bencer3283/IoT-Lab/HW1/HW1-BOM.xlsx

Comment | Designator | Footprint | Quantity | Value | Manufacturer Part Number | Manufacturer_Part_Number | Mouser Part Number
Cap Semi | 3.3v-10uf | C1206 | 1 | 10uF |  |  | 80-C1206C106K4P
Cap Semi | 3.3v-47uf | C1206 | 1 | 47uF |  | C3216X7S0J476M160AC
AMS1117-3.3 | 3.3v supply | SOT229P700X180-4N | 1 |  |  | AMS1117-3.3
PJ-047A | 5V jack | FP-PJ-047A-MFG | 1 |  | PJ-047A | PJ-047A
Inductor | analogdecouple, analogdecouple2 | INDC1608L | 2 | 10uH |  | KLZ1608MHR100WTD25
Cap Semi | crystal1, crystal2 | C1206 | 2 | 22uF |  | CC1206KKX5R6BB226
TSX-3225 16.0000MF18X-AC3 | Crystal | EPSON-TSX-3225_V | 1 |  |  |  | 732-TX325-16F09Z-AC3
Res3 | current-limit5v, current-limit33 | J1-0603 | 2 | 330 |  |  | 667-ERJ-3EKF3300V
 | decouple, decouple1, decouple2, decouple4 | C1206 | 4 | 100nF |  |  | 80-C1206C104K5RACLR
Res3 | dht-pull-up, photodiodeR, reset | J1-0603 | 3 | 10K |  |  | 603-RC0603FR-0710KL
Res3 | ds18pull-up | J1-0603 | 1 | 4.7K |  |  | 71-CRCW06034K70JNEAC
ATmega328P-AU | MCU1 | 32A_N | 1 |  |  | ATMEGA328P-AU
BPW21R | Photodiode | VISH-BPW21R-2 | 1 |  |  | BPW21R
LED2 | power, power33 | 3.2X1.6X1.1 | 2 |  |  | APTR3216SECK
Header 3X2 | Programming | HDR2X3 | 1 |  |  | 206832-0601
PTS636_SK43_SMTR_LFS | resetSwitch | PTS636SK43SMTRLFS | 1 |  |  | PTS636 SK43 SMTR LFS | 611-PTS636SK43SMTRLF
DHT22 | Thermal&Humiditysensor1 | DHT22 | 1 |  |  | DHT22
DS18B20+ | Thermalsnesor1 | Q3+1 | 1 |  |  | DS18B20+
XB24CZ7PIT-004 | XBee | XB24CAPIT-001 | 1 |  |  | XB24CZ7PIT-004 | 888-XB24CZ7PIT-004
