bencer3283/IoT-Lab/HW1/HW1.pdf

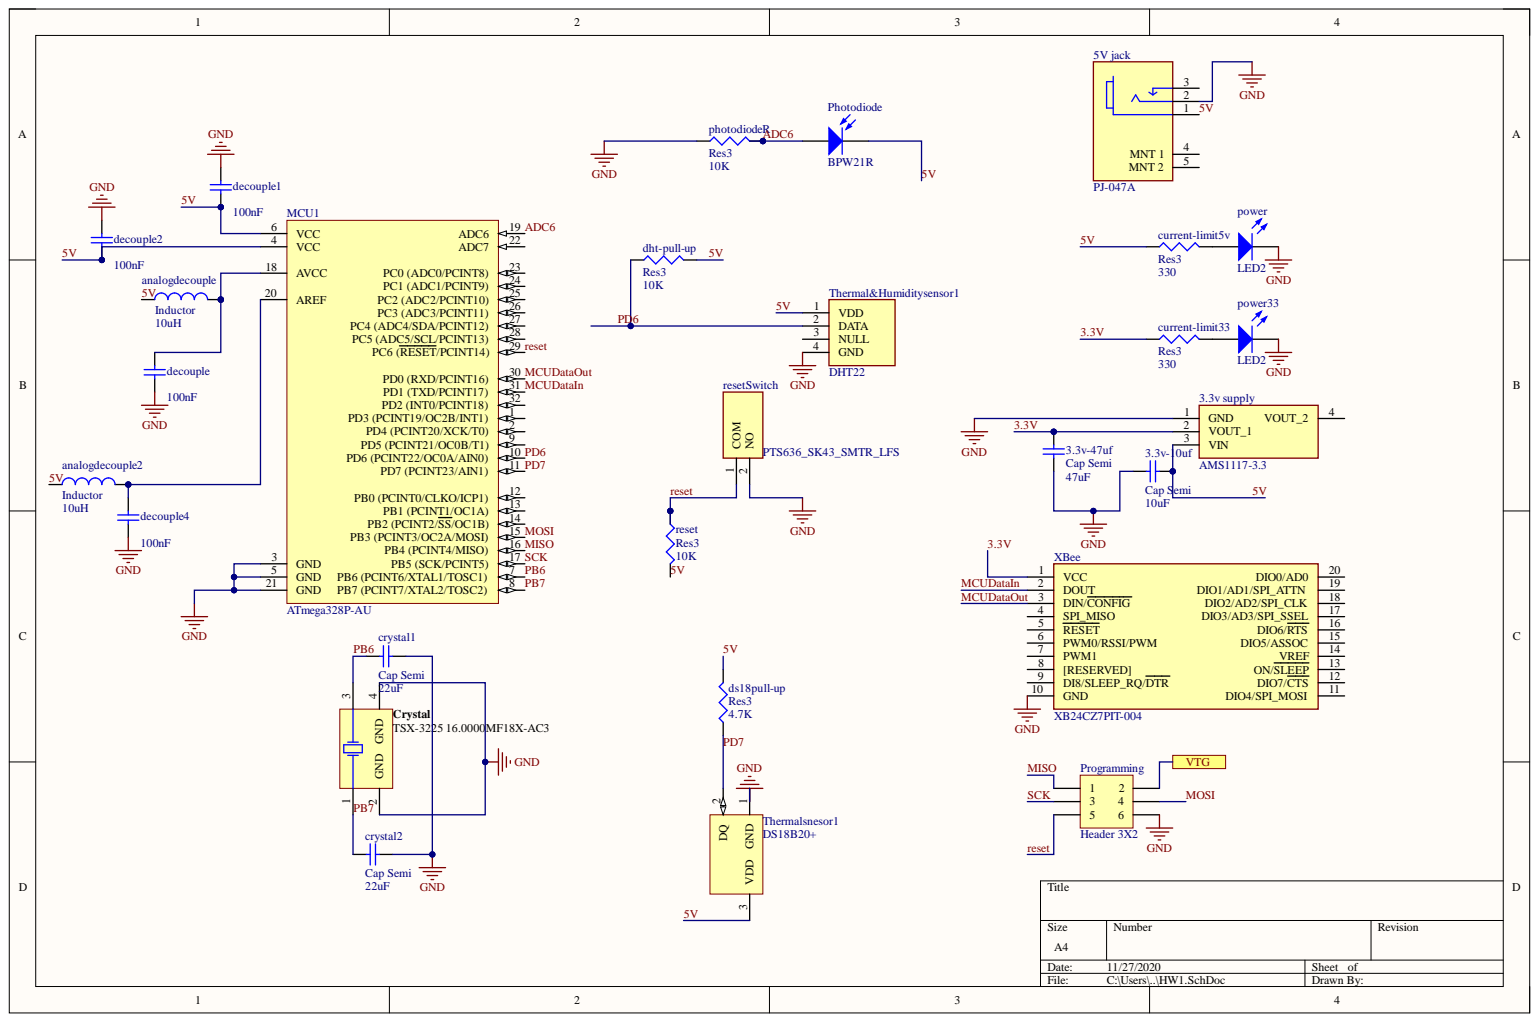
[picture p17: page 1]

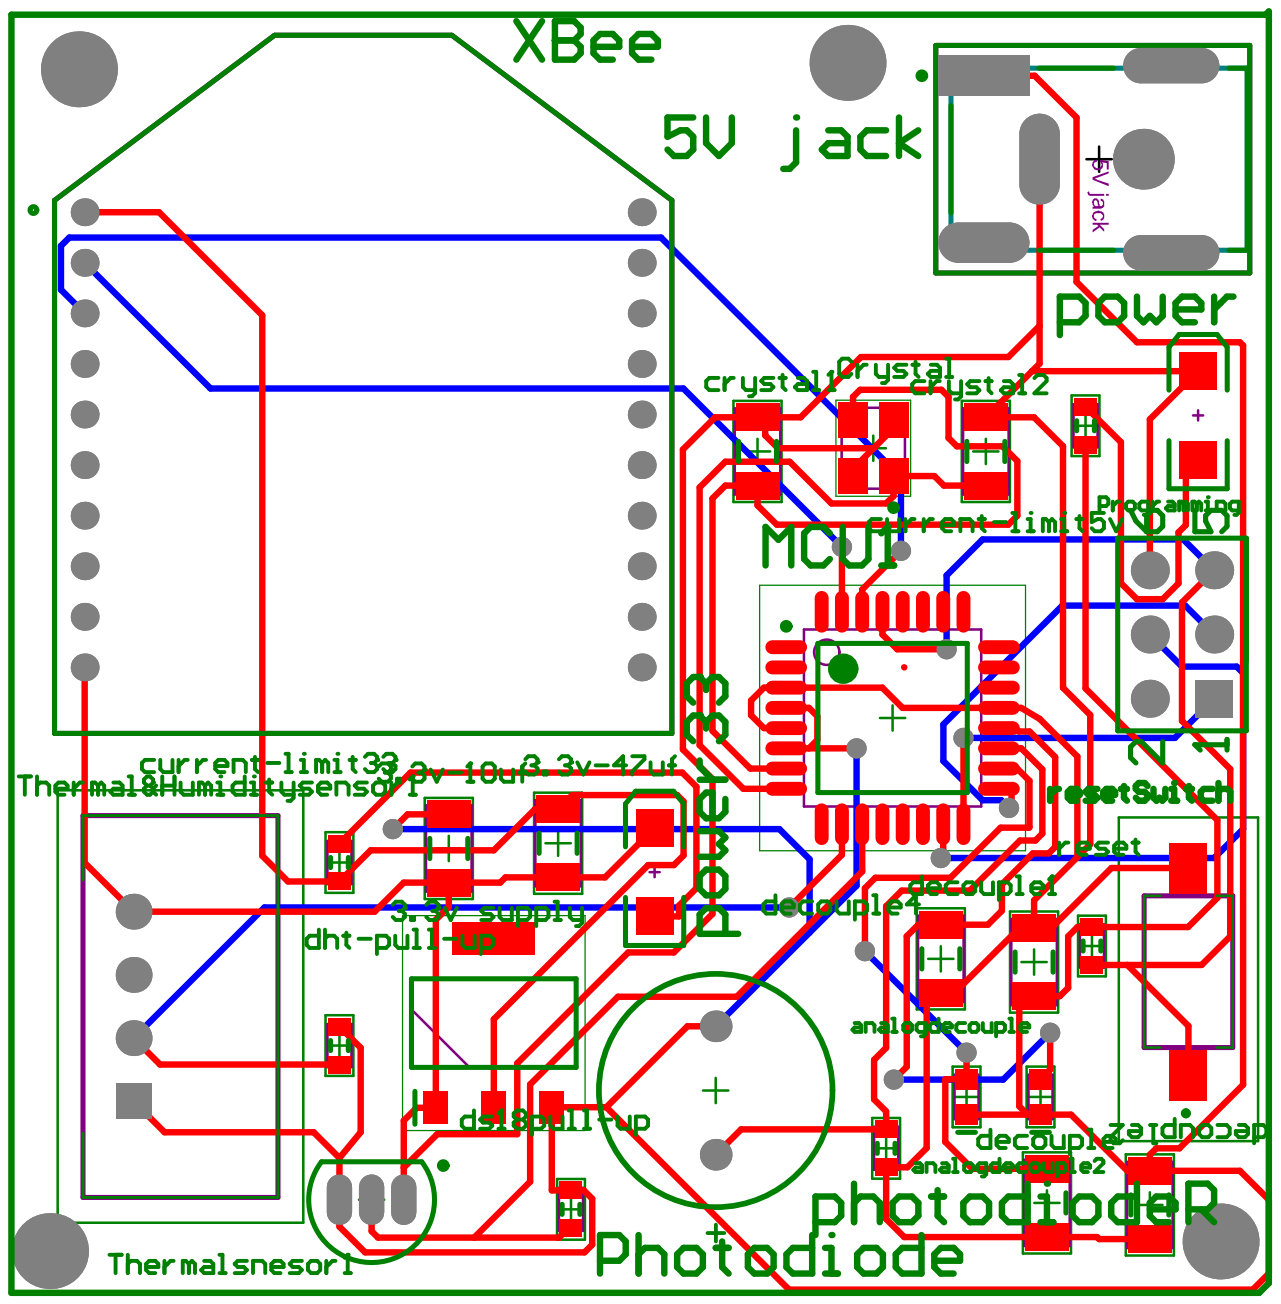
[picture p18: page 2]

Part List | Bill of Materials for Project [HW1.PrjPcb] (No PCB Document Selected)
Source Data From: | HW1.PrjPcb
Project: | | HW1.PrjPcb
Variant: | | None
Report Date: | 2020/11/27 | 上午 11:05
Print Date: | 27-Nov-20 | 11:09:19 AM
Designator | Comment | LibRef | Footprint | Description
3.3v-10uf | Cap Semi | Cap Semi | C1206 | Capacitor (Semiconductor SIM Model)
3.3v-47uf | Cap Semi | Cap Semi | C1206 | Capacitor (Semiconductor SIM Model)
3.3v supply | AMS1117-3.3 | AMS1117-3.3 | SOT229P700X180-4N | Integrated Circuit
5V jack | PJ-047A | CMP-14830-000005-1 | FP-PJ-047A-MFG | CONN PWR JACK 2X5.5MM SOLDER
analogdecouple, analogdecouple2 | Inductor | Inductor | INDC1608L | Inductor
crystal1, crystal2 | Cap Semi | Cap Semi | C1206 | Capacitor (Semiconductor SIM Model)
Crystal | TSX-3225 16.0000MF18X-AC3 | CMP-2000-07332-1 | EPSON-TSX-3225_V | MHz Range Crystal Unit, 16 MHz, -40 to 85 degC, 4-Pin SMD, RoHS, Tape and Reel
current-limit5v, current-limit33 | Res3 | Res3 | J1-0603 | Resistor
decouple, decouple1, decouple2, decouple4 | | Cap Semi | C1206 | Capacitor (Semiconductor SIM Model)
dht-pull-up, photodiodeR, reset | Res3 | Res3 | J1-0603 | Resistor
ds18pull-up | Res3 | Res3 | J1-0603 | Resistor
MCU1 | ATmega328P-AU | CMP-0095-00269-2 | 32A_N | 8-bit AVR Microcontroller, 32KB Flash, 1KB EEPROM, 2KB SRAM, 32-pin TQFP, Industrial Grade (-40°C to 85°C)
Photodiode | BPW21R | CMP-2000-05428-1 | VISH-BPW21R-2 | Silicon Photodiode, 565 nm, -40 to 125 degC, 2-Pin TO-5, RoHS, Bulk
power, power33 | LED2 | LED2 | 3.2X1.6X1.1 | Typical RED, GREEN, YELLOW, AMBER GaAs LED
Programming | Header 3X2 | Header 3X2 | HDR2X3 | Header, 3-Pin, Dual row
resetSwitch | PTS636_SK43_SMTR_LFS | PTS636_SK43_SMTR_LFS | PTS636SK43SMTRLFS | Switch
Thermal&Humidit ysensor1 | DHT22 | DHT22 | DHT22 | Integrated Circuit
Thermalsnesor1 | DS18B20+ | CMP-0253-00003-1 | Q3+1 | Programmable Resolution Digital Thermometer, 1-Wire Interface, ±0.5°C Accuracy, 3-Pin TO92, -55°C to +125°C, Pb-Free
XBee | XB24CZ7PIT-004 | XB24CZ7PIT-004 | XB24CAPIT-001 | Integrated Circuit
