bencer3283/IoT-Lab/(list of files, drawings)

Other design files:
HW1.SchDoc
HW1/HW1.PrjPcb
HW1PCB1.PcbDoc
