bencer3283/IoT-Lab/(commit log)

2020-11-04 altium designer getting started
    [HW1.PrjPcb, HW1.SchDoc, HW1PCB1.PcbDoc]
2020-11-04 PCB HW1 modified
    [HW1.SchDoc, HW1PCB1.PcbDoc]
2020-11-16 atmega328p wiring pending fixes
    [HW1.SchDoc, HW1PCB1.PcbDoc]
2020-11-16 atmega328p wiring pending fixes-2
2020-11-16 burner pending
    [HW1.SchDoc]
2020-11-16 layout pending
    [HW1.SchDoc, HW1PCB1.PcbDoc]
2020-11-16 ver. 0.1116
    [HW1.SchDoc, HW1PCB1.PcbDoc]
2020-11-16 add pdf
    [HW1PCB1.PcbDoc]
2020-11-16 ver. 0.1116.1
    [HW1.PrjPcb, HW1.SchDoc, HW1PCB1.PcbDoc]
2020-11-26 R/L in 0603(inch), C in 1206(inch)
    [HW1.PrjPcb, HW1.SchDoc, HW1PCB1.PcbDoc]
2020-11-26 add screw hole
    [HW1PCB1.PcbDoc]
2020-11-26 fabrication output
    [HW1.SchDoc, HW1.xlsx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]
2020-11-26 fabrication output-2
    [HW1.PrjPcb]
2020-11-26 switch modification
    [HW1-BOM.xlsx, HW1.PrjPcb, HW1.SchDoc, HW1.xlsx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]
2021-05-12 sensor transmit ok
    [HW1-BOM.xlsx, HW1.PrjPcb, HW1.SchDoc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]
2021-06-09 add board debug result
